Oui-Dev/DISLED/hardware/pcb/connected_status_light.step

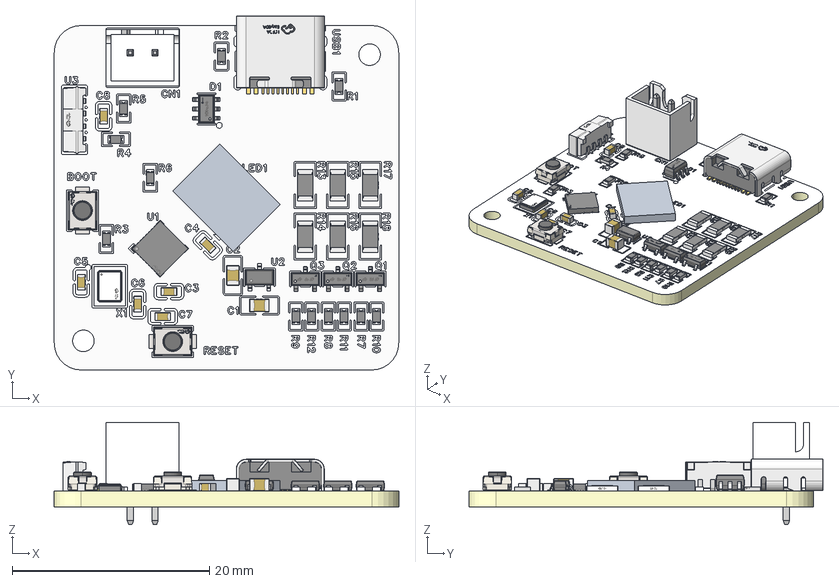
[picture p1: CAD file, 2026-10-25]
hardware/pcb/connected_status_light.step
35.0 x 35.9 x 10.4 mm
Board~z7Zc
TopCopper~z7Zc
BottomCopper~z7Zc
TopSilkscreen~z7Zc x 200
BottomSilkscreen~z7Zc x 48
TopFpcStiffener~z7Zc
BottomFpcStiffener~z7Zc
LED-SMD_6P-L5.0-W5.0-P1.70-LS5.3-TL~default_model~z7Zc
R1206~R1206_L3.2-W1.6-H0.6~z7Zc x 6
R0603~R0603~z7Zc x 12
C0805~C0805_L2.0-W1.3-H1.3~z7Zc x 2
C0603~C0603_L1.6-W0.8-H0.8~z7Zc x 6
SW-SMD_L3.9-W3.0-P4.45~SW-SMD_L3.9-W2.9-H2.0-LS4.8~z7Zc x 2
CRYSTAL-SMD_4P-L3.2-W2.5-BL_SIT8008BI~CRYSTAL-SMD_4P-L3.2-W2.5-BL_ SIT8008BI~z7Zc
LED-SMD_4P-L6.8-W2.4_VEML7700-TR~LED-SMD_4P-L6.8-W2.4_VEML7700-TR~z7Zc
SOT-23-3_L2.9-W1.6-P1.90-LS2.8-BR~SOT-23-3L_ L2.9-W1.6-H1.1-LS2.8-P0.95~z7Zc
QFN-28_L4.0-W4.0-P0.40-BL-EP2.7~QFN-28_L4.0-W4.0-P0.40-BL-EP2.7~z7Zc
USB-C_SMD-TYPE-C-31-M-12_1~USB-C_SMD-TYPE-C-31-M-12_1~z7Zc
CONN-TH_B2B-XH-AM-LF-SN~CONN-TH_B2B-XH-AM-LF-SN~z7Zc
SOT-23-3_L2.9-W1.3-P1.90-LS2.4-BR~SOT-23-3P_ L2.9-W1.3-H1.0-LS2.4-P0.95~z7Zc x 3
SOT-23-6_L2.9-W1.6-P0.95-LS2.8-BL~SOT-23-6_ L2.9-W1.6-H1.5-LS2.8-P0.95~z7Zc
