Oui-Dev/DISLED/hardware/enclosure/top.3mf

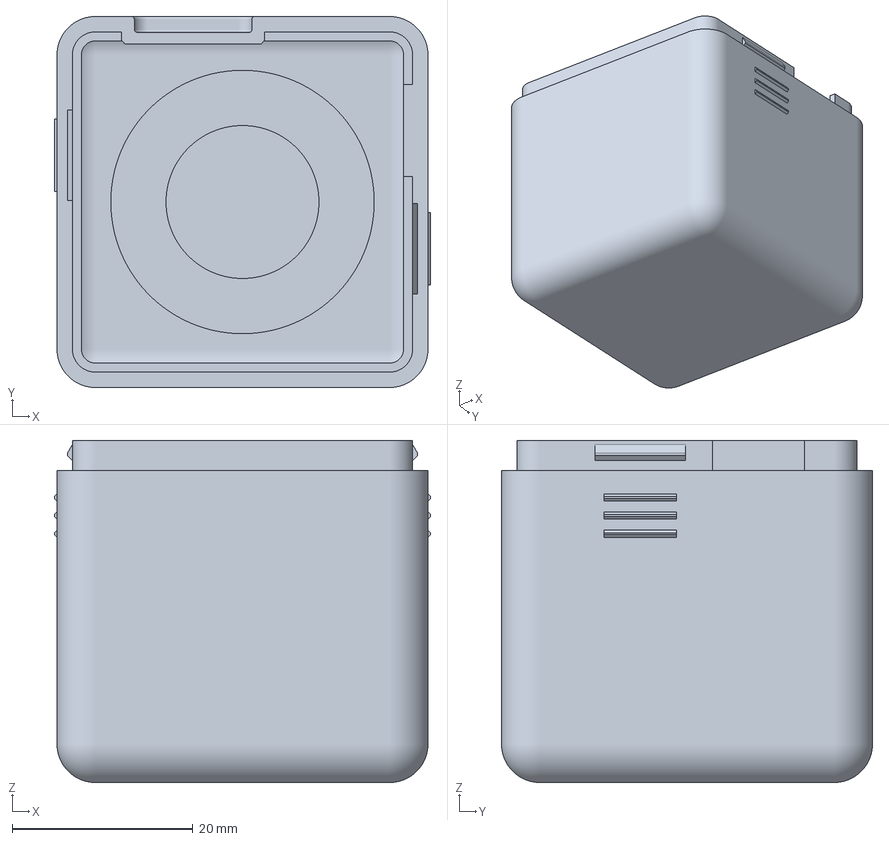
[picture p2: CAD file, 2026-10-31]
hardware/enclosure/top.3mf
41.6 x 41.0 x 37.8 mm
