Oui-Dev/DISLED/hardware/enclosure/copper_ring_cutter.3mf

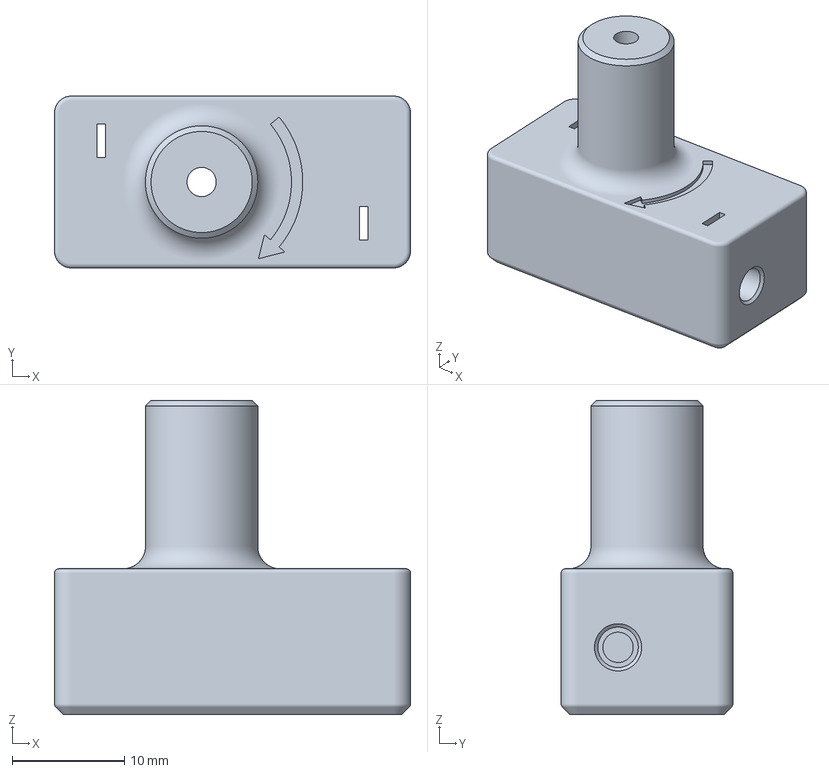
[picture p3: CAD file, 2026-10-24]
hardware/enclosure/copper_ring_cutter.3mf
31.7 x 15.3 x 28.0 mm
