Oui-Dev/DISLED/hardware/enclosure/als_light_cover.3mf

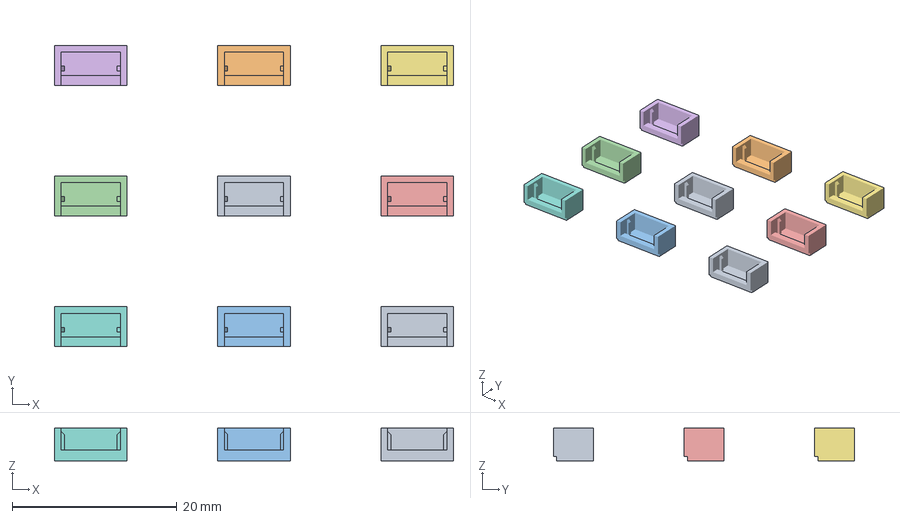
[picture p4: CAD file, 2026-10-24]
hardware/enclosure/als_light_cover.3mf
48.4 x 36.6 x 4.00 mm
als_light_cover x 9
