Oui-Dev/DISLED/hardware/enclosure/anti_slip_foot.3mf

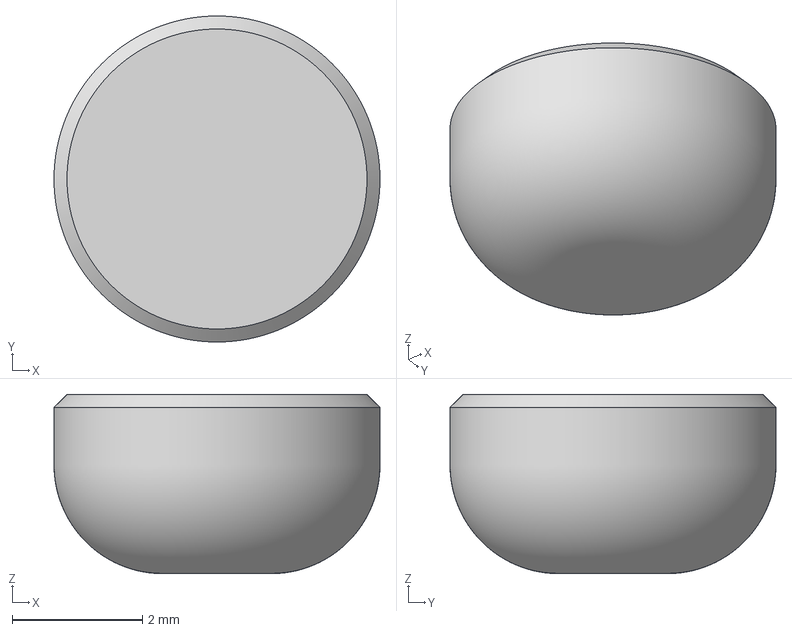
[picture p5: CAD file, 2026-10-19]
hardware/enclosure/anti_slip_foot.3mf
5.00 x 5.00 x 2.75 mm
