Oui-Dev/DISLED/(list of files, cad)

Other CAD files:
hardware/enclosure/bottom.3mf
