Oui-Dev/DISLED/app/src-tauri/installer/dmg-background.png

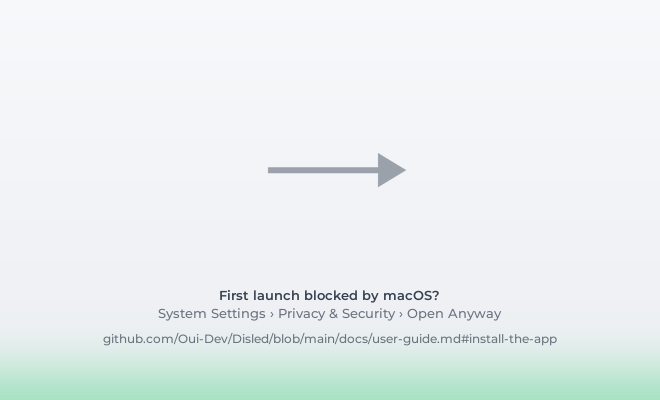
app/src-tauri/installer/dmg-background.png
