Oui-Dev/DISLED/app/src-tauri/installer/nsis-sidebar.bmp

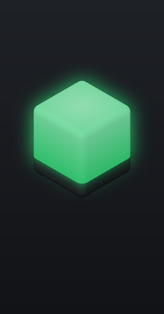
app/src-tauri/installer/nsis-sidebar.bmp
