Oui-Dev/DISLED/docs/images/user-guide/colors-dark.png

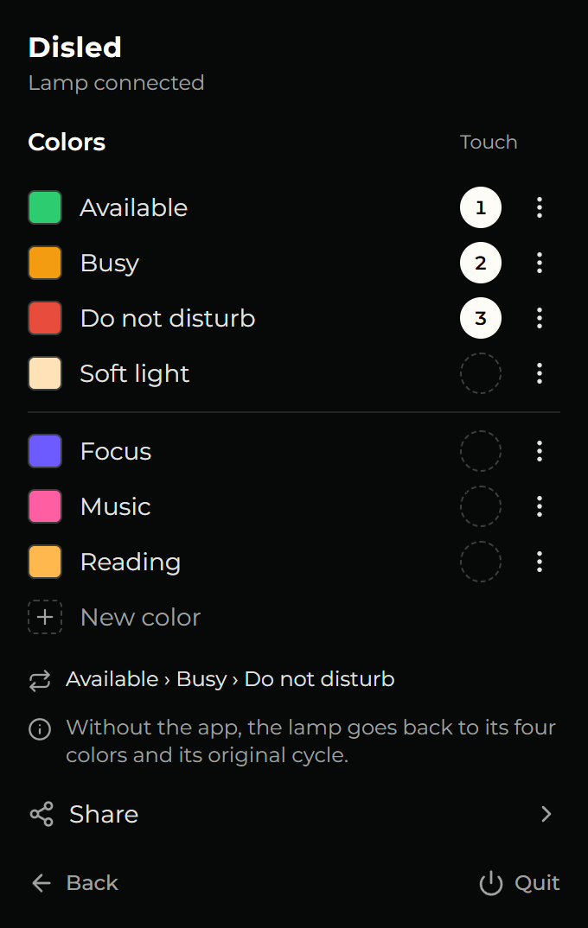
docs/images/user-guide/colors-dark.png
