Oui-Dev/DISLED/docs/images/user-guide/diagnostics-dark.png

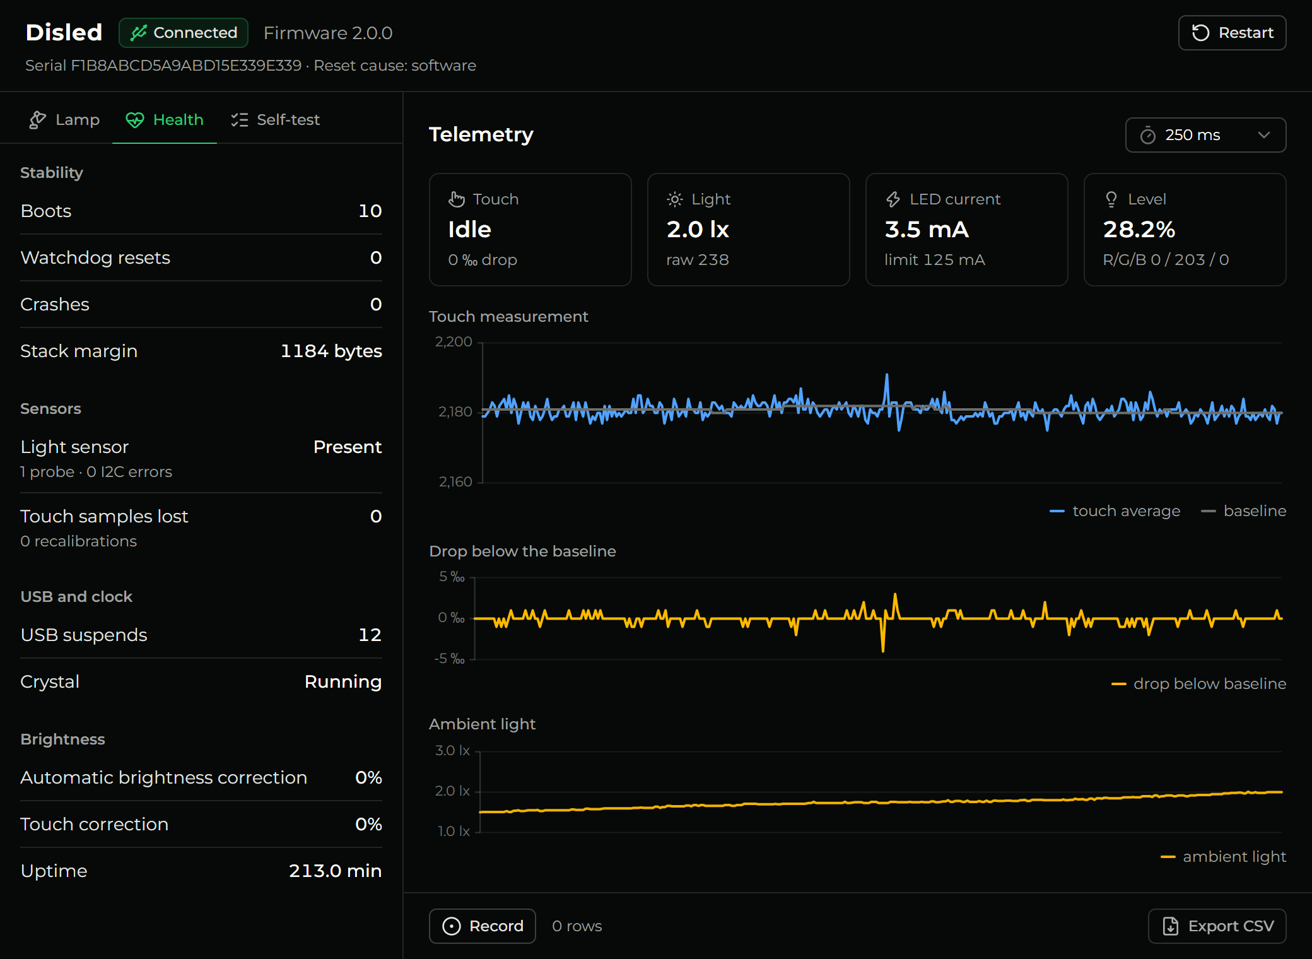
docs/images/user-guide/diagnostics-dark.png
