Oui-Dev/DISLED/docs/images/user-guide/lamp-update-dark.png

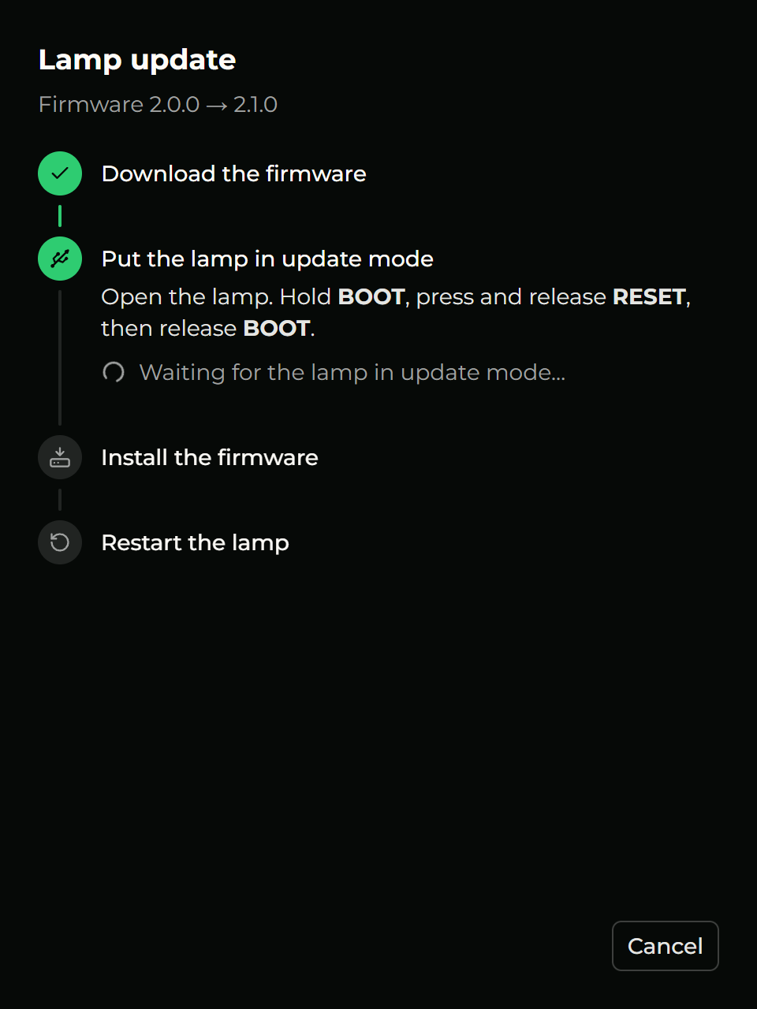
docs/images/user-guide/lamp-update-dark.png
