Oui-Dev/DISLED/docs/images/user-guide/popup-lamp-dark.png

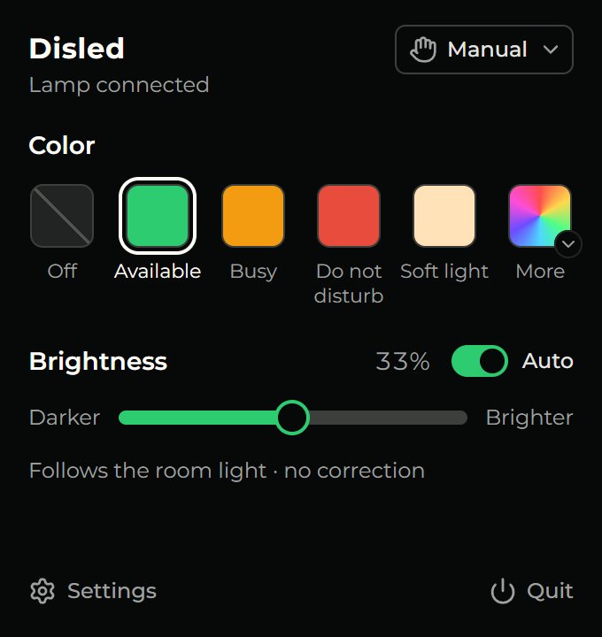
docs/images/user-guide/popup-lamp-dark.png
