Oui-Dev/DISLED/docs/images/user-guide/popup-settings-dark.png

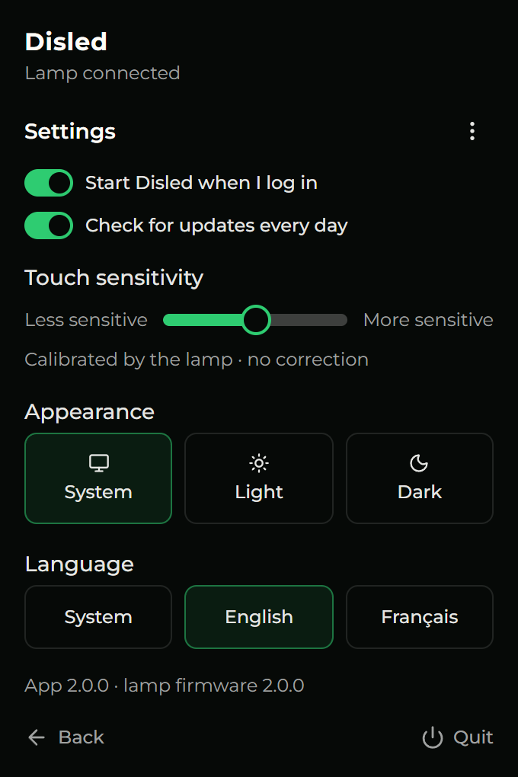
docs/images/user-guide/popup-settings-dark.png
