Oui-Dev/DISLED/firmware/src/drivers/tkey.c

/*
 * SPDX-License-Identifier: GPL-3.0-or-later
 * SPDX-FileCopyrightText: 2026 The Disled contributors
 * Additional permission under GNU GPL version 3 section 7: see LICENSING.md.
 */
#include "tkey.h"

#include <stddef.h>

#include "bsp/board.h"
#include "bsp/bsp_gpio.h"
#include "bsp/bsp_time.h"
#include "bsp/ch32.h"
#include "led_pwm.h"

/* ADC_CTLR1 touch-key bits (WCH TouchKey example, CH32V20x EVT). */
#define ADC_CTLR1_TKENABLE (1u << 24)
#define ADC_CTLR1_BUFEN    (1u << 26)

/* Power of two, so the indices wrap with a mask. */
#define QUEUE_SIZE 32u

/* A measurement takes about 5 us; give up after roughly 100 us. */
#define MEASURE_MAX_POLLS 2000u

typedef struct {
    uint16_t value;
    uint32_t time_ms;
} sample_t;

static uint8_t s_charge_time;
static uint8_t s_discharge_time;
/* Volatile as the indices, so that a slot is read before s_tail frees it
 * to the interrupt. */
static volatile sample_t s_queue[QUEUE_SIZE];
static volatile uint32_t s_head; /* written by the interrupt */
static volatile uint32_t s_tail; /* written by the main loop */
static volatile uint32_t s_lost;

void tkey_init(const tkey_config_t *config)
{
    s_charge_time = config->charge_time;
    s_discharge_time = config->discharge_time;

    RCC_APB2PeriphClockCmd(RCC_APB2Periph_ADC1, ENABLE);
    bsp_gpio_config(BOARD_TOUCH_PORT, BOARD_TOUCH_PIN, GPIO_Mode_AIN, GPIO_Speed_2MHz);

    /* One conversion of the touch channel, started by software: the reset
     * values but for the trigger and the sample time (channel 9: SAMPTR2). */
    ADC1->CTLR2 = ADC_ExternalTrigConv_None;
    ADC1->SAMPTR2 = (uint32_t)config->adc_sample_time << (3u * BOARD_TOUCH_ADC_CHANNEL);
    ADC1->RSQR3 = BOARD_TOUCH_ADC_CHANNEL;
}

/* Runs in the TIM3 interrupt, at the sample point of the PWM period. */
static void measure(void)
{
    /* Writing the charge then the discharge time starts the measurement;
     * it lasts a few microseconds. */
    TKey1->IDATAR1 = s_charge_time;
    TKey1->RDATAR = s_discharge_time;
    uint32_t polls = 0;
    while ((ADC1->STATR & ADC_EOC) == 0u) {
        if (++polls >= MEASURE_MAX_POLLS) {
            s_lost++;
            return;
        }
    }
    const uint16_t value = (uint16_t)TKey1->RDATAR;

    const uint32_t head = s_head;
    if (head - s_tail >= QUEUE_SIZE) {
        s_lost++;
        return;
    }
    s_queue[head & (QUEUE_SIZE - 1u)] = (sample_t){ value, bsp_time_ms() };
    s_head = head + 1u;
}

void tkey_start(void)
{
    ADC1->CTLR2 |= ADC_ADON;
    TKey1->CTLR1 |= ADC_CTLR1_TKENABLE | ADC_CTLR1_BUFEN;
    led_pwm_set_sample_callback(measure);
    /* Every millisecond, from the SysTick interrupt. */
    bsp_time_set_tick_hook(led_pwm_arm_sample);
}

void tkey_stop(void)
{
    bsp_time_set_tick_hook(NULL);
    led_pwm_set_sample_callback(NULL);
    /* Powered down, within the 2.5 mA of a suspended USB device. */
    TKey1->CTLR1 &= ~(ADC_CTLR1_TKENABLE | ADC_CTLR1_BUFEN);
    ADC1->CTLR2 &= ~ADC_ADON;
}

bool tkey_read(uint16_t *sample, uint32_t *time_ms)
{
    const uint32_t tail = s_tail;
    if (tail == s_head) {
        return false;
    }
    const sample_t entry = s_queue[tail & (QUEUE_SIZE - 1u)];
    s_tail = tail + 1u;
    *sample = entry.value;
    *time_ms = entry.time_ms;
    return true;
}

uint32_t tkey_samples_lost(void)
{
    return s_lost;
}
