Oui-Dev/DISLED/firmware/src/bsp/bsp_fault.h

/*
 * SPDX-License-Identifier: GPL-3.0-or-later
 * SPDX-FileCopyrightText: 2026 The Disled contributors
 * Additional permission under GNU GPL version 3 section 7: see LICENSING.md.
 *
 * Fault capture: an exception or a failed assertion saves its cause in the
 * backup registers, which survive a reset but not a power cycle, for the next
 * boot to report. They also count boots, watchdog resets and faults.
 */
#ifndef DISLED_BSP_FAULT_H
#define DISLED_BSP_FAULT_H

#include <stdbool.h>
#include <stdint.h>

/* mcause of a failed DISLED_ASSERT: 0x0A55nnnn, nnnn = source line. */
#define BSP_FAULT_ASSERT_CAUSE 0x0A550000u

typedef struct {
    bool valid;
    uint32_t mcause; /* exception cause (RISC-V mcause) */
    uint32_t mepc;   /* address of the faulting instruction */
    uint32_t mtval;  /* faulting address or instruction */
} fault_record_t;

typedef struct {
    uint16_t boots;          /* since power-up, this one included */
    uint8_t watchdog_resets; /* since power-up, saturates at 255 */
    uint8_t faults;          /* since power-up, saturates at 255 */
    fault_record_t last;     /* last fault since power-up (valid if faults > 0) */
} fault_stats_t;

/* Reads the record left by a fault just before this boot (valid only then)
 * and updates the counters. Call once at boot, after bsp_init(). */
fault_record_t bsp_fault_take(void);

fault_stats_t bsp_fault_stats(void);

#endif /* DISLED_BSP_FAULT_H */
