Oui-Dev/DISLED/(commit log)

2026-10-11 chore: bootstrap monorepo layout, licensing and decision records
    Move the PCB design files into hardware/ (unchanged content), add the
    GPL-3.0-or-later license with a GPLv3 section 7 permission for the WCH
    SDK, the CERN-OHL-S-2.0 hardware license, the lamp behavior
    specification and the architecture decision records for phase 1.
2026-10-11 build(firmware): PlatformIO project with TinyUSB, toolchain spike
    Pin platform-ch32v, the WCH NoneOS SDK and TinyUSB 0.21.0 (submodule),
    add debug/release/native environments, a git-based version script and a
    flash/RAM budget check. The spike builds a vendor HID device with the
    USB descriptors, the 1 ms time base and the USB interrupt glue; ADR 0008
    records the results (interrupt convention, clock tree, memory baseline).
2026-10-11 feat(core): lamp logic, touch detection, light pipeline and protocol codec
    Add the hardware-independent firmware library disled_core:
    - lamp_fsm: power, color cycle and host requests (docs/behavior.md);
    - touch_detector: windowed averaging, drifting baseline, hysteresis,
    debounce, short/long press, object and inverted-touch recalibration;
    - brightness: log-lux curve, slow filter with dead band, manual mode;
    - color, power_limiter, led_output: CIE L* dimming, hue-preserving
    current cap per USB state, fades, single path to the PWM duties;
    - protocol: HID v1 command decoder and message encoders.
    65 Unity tests run natively (pio test -e native); the library also
    builds for the CH32V203 with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
2026-10-11 feat(firmware): board support and peripheral drivers
    - bsp: pin map of board rev 4 (review N3 pins left untouched), clock
    check and ADC clock limit, reset cause, unused pins as analog inputs,
    1 ms tick hook, independent watchdog, fault capture in the backup
    registers;
    - drivers: TIM3 LED PWM with a PWM-synchronous sample point (channel 4,
    output disabled), TouchKey sampling queue with bounded conversion
    wait and phase dithering for the V4 tests, blocking I2C master with
    timeouts and bus recovery, VEML7700 ambient light sensor.
    [board.h, bsp.c, bsp.h, bsp_fault.c, bsp_fault.h, bsp_time.c, bsp_time.h, bsp_watchdog.c]
2026-10-11 feat(firmware): USB transport, debug console and application MVP
    - usb_device: link state (unconfigured/configured/suspended), HID
    command and message queues, CDC console stream in debug builds;
    - diag: timestamped logs and a line console (debug builds only), on top
    of a small heap-free formatter in disled_core;
    - scheduler: table-driven cooperative scheduler in disled_core;
    - app: wiring of touch, light sensor, LED output and host protocol,
    notifications with a state sequence number, rate-limited automatic
    level updates, telemetry stream, delayed RESET, watchdog, WFI idle;
    - app_config: every tunable in one place, first guesses marked "tune";
    - remove 64-bit divisions and enable LTO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
    [app.c, app.h, app_config.c, app_config.h, app_console.c, app_console.h, app_context.h, app_host.c]
2026-10-11 feat(protocol): HID protocol v1 specification and shared test vectors
    protocol/README.md specifies transport, frame, commands and messages.
    protocol/vectors/v1.json holds 16 command and 6 message vectors written
    from the specification by an independent encoder. A PlatformIO script
    turns them into a C header for the native tests, so the firmware codec
    is checked byte for byte; the desktop app will use the same file.
2026-10-11 fix(firmware): one state_seq step per STATE message with new content
    The sequence number grew on every observed change, but notifications
    caused by automatic brightness are throttled and merged, so the host saw
    gaps it could not tell from lost messages. It now grows once per STATE
    message that carries a change; replies without change repeat it, and a
    failed send does not consume a number. Spec updated accordingly.
    [app_host.c]
2026-10-11 feat(app): Tauri 2 test and tuning app
    Rust backend: protocol codec checked against protocol/vectors/v1.json,
    USB worker thread with discovery, reconnection and protocol version
    check, commands to send requests and save CSV recordings. Vue 3 front
    end: connection header, lamp controls that follow the lamp state, live
    telemetry charts and CSV recording. Strict CSP, minimal capabilities.
    Checks: vue-tsc, ESLint, Prettier, rustfmt, clippy -D warnings,
    cargo test (5 tests). Release build compiles (no bundle yet).
2026-10-11 style(firmware): clang-format 23 and cppcheck gate
    Format every firmware source with clang-format 23.1.3 (config in
    firmware/.clang-format; the two tuning tables stay hand-aligned). Run
    cppcheck through pio check on src/ and lib/disled_core at every
    severity; fix its three style findings.
    [app.c, app_config.c, app_console.c, app_host.c, board.h, bsp.c, bsp_time.c, bsp_uid.h]
2026-10-11 fix(firmware): skip light readings until the sensor settles
    Right after power-on or re-initialization the VEML7700 returns 0 until
    its first integration completes. The first reading also seeds the
    brightness filter, so the lamp started at its minimum and crawled up for
    seconds. Readings are now ignored for two integration times, and a
    silent sensor at start-up is probed again after 200 ms instead of 5 s.
    [app.c, app_config.h, app_context.h]
2026-10-19 fix(firmware): bring-up fixes on the first v4 board
    Found on real hardware, all verified on the board:
    - remove the WFI idle: the QingKe core never woke from it, not even on
    the 1 ms tick, so USB never enumerated and the watchdog reset the chip
    every 2 s (low-power idle is phase 2 work);
    - PCLK1 at 36 MHz: the SDK writes PCLK1 in MHz into the 6-bit I2C FREQ
    field before clamping it to 60, so 72 MHz became 8 MHz; APB1 timers now
    run at 72 MHz (PWM 20 kHz with 3600 steps);
    - I2C: WCH-style byte-by-byte reception, bus release and full peripheral
    reset at init and after a failed transfer, clean STOP in the release
    sequence (a START glitch made the next transfer lose arbitration),
    b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
    [app.c, app_console.c, bsp.c, i2c_bus.c, i2c_bus.h]
2026-10-19 feat(firmware): tune warm white and the low brightness end on the board
    - warm white R 63000, G 58000, B 1600 (was 65535/36000/9000, clearly
    pink through the PLA), tuned by eye with the new console command;
    - automatic brightness curve x1.5 below 10 lx (1 lx 3 %, 10 lx 12 %):
    too dim through the PLA in a dark room;
    - console "palette": show or change the colors live (RAM copy), for
    color calibration without reflashing.
2026-10-19 feat(firmware): TouchKey timing measured on the board
    The WCH example timing (charge 16, ADC sample 7.5 cycles) saturates the
    reading at 4093 whatever the electrode does. A live sweep showed that
    the ADC sample time sets the range and the charge time the position in
    it: charge 3 with 1.5 cycles reads about 2600 at rest, with about +-6
    per mille of noise, and a finger on the bare electrode lowers it by
    about 100 per mille. Short and long press, object absorption and
    inverted-touch recalibration worked on the board with these values.
    - tkey_config_t gains the ADC sample time;
    - console "touch charge <c> <d> [s]" tunes the timing live.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
    [app_config.c, app_console.c, tkey.c, tkey.h]
2026-10-19 feat(firmware): tune the orange on the board
    The first orange was hard to tell from the red through the PLA.
2026-10-19 feat(firmware): touch thresholds and orange for the closed enclosure
    Measured through the closed enclosure: a one-hand touch lowers the
    reading by 44-57 per mille, so the 40 per mille threshold left little
    margin. Also keeps the orange the user tuned by hand (green 29000).
2026-10-19 feat(firmware): touch detection with a hand resting near the lid
    Closed-enclosure taps at bring-up showed two faults:
    - a hand near the lid (10-30 per mille) pulled the baseline down by up to
    15 per mille, so later touches needed to land on the electrode ring;
    - with the hand resting near the lid, the signal stayed above the release
    threshold between light taps, which merged into one press (one merge
    lasted 1.7 s, close to a false long press).
    The baseline now freezes in a proximity band (absorbed after the object
    time), press and release are also relative to the floor of the last
    320 ms, and a release re-arms after 100 ms. Replayed on a 33 s recording,
    22 taps are found where the old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
2026-10-19 feat(firmware): shorter touch debounce
    60 ms missed a light tap of about 60 ms through the closed enclosure.
    Replayed on both recordings, 40 ms catches it and adds no false press.
    [app_config.c]
2026-10-19 feat(firmware): compensate the light lost per PWM pulse
    Warm white turned yellow at low levels: at 10 % its blue is a 1-tick
    (14 ns) pulse, too short to light the LED. Each lit channel now gets a
    per-channel pulse loss added to its duty; 5 ticks (70 ns) on blue gave
    back the hue seen at 100 % (tuned by eye). Red and green are not measured
    yet; the console 'pulse' command tunes the losses in RAM.
    Also runs clang-format on the bring-up changes, which repairs the
    DISLED_BOOT_DIAG task macro.
    [app.c, app_config.c, app_config.h, app_console.c]
2026-10-19 feat(firmware): dither the LED PWM to 1/16 of a tick
    At the bottom of the range a channel is only a few 14 ns ticks long:
    whole ticks made the pulse-loss correction too coarse (warm white at
    3 % and 10 % wanted different blue values) and gave visible steps in
    dim fades. The TIM3 update interrupt now dithers each duty over 16
    periods (pattern at 1.25 kHz or faster); led_output works in sub-ticks.
    The telemetry still reports whole ticks.
    Blue pulse loss tuned by eye to 4 3/16 ticks, good at 3 % and 10 %.
    Touch noise unchanged with the interrupt running every period.
    [app.c, app_config.c, app_console.c, app_host.c, led_pwm.c, led_pwm.h, test_pwm_dither.c]
2026-10-19 feat(hardware): add initial 3D models for device housing and mechanical parts
    [als_light_cover.3mf, anti_slip_foot.3mf, bottom_housing.3mf, copper_disk_cutter.3mf, copper_disk_cutter_blade_holder.3mf, top_housing.3mf]
2026-10-19 docs: record the first board bring-up
    - ADR 0009: the design changes the bring-up forced (PCLK1 at 36 MHz and
    a 3600-tick PWM, no WFI, WCH-style I2C reads and bus recovery, LED
    dithering and pulse loss, floor-relative touch detection).
    - Measurements of board F1B9ABCD5A9BBD15E339E339, with the touch
    recordings and what is deferred to the enclosure V2.
    - touch_replay: replays a console recording through touch_detector on
    the build machine, to compare settings before flashing.
    - Architecture, bring-up procedure and protocol notes brought up to date;
    stale 7200-tick references fixed.
    [app_config.h, bsp.c]
2026-10-19 ci: automate releases with release-please
    On every push to main, release-please keeps one release pull request per
    component (firmware fw-vX.Y.Z, app app-vX.Y.Z) with the next version and
    the changelog from the conventional commits. Merging it tags and
    publishes the GitHub release, then the workflow attaches:
    - firmware: release and debug .hex/.bin/.elf with SHA256SUMS;
    - app: Windows .exe (NSIS), macOS .dmg (Apple Silicon), Linux .deb and
    .AppImage, unsigned.
    The app version now lives only in package.json: tauri.conf.json reads it
    and Cargo.toml no longer carries one. The root changelog points to the
    per-component changelogs. docs/releasing.md describes the flow and the
    repository settin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
2026-10-20 fix(app): let the logged-in user reach the lamp on Linux
    Linux lets only root open a USB HID device, so the app could not reach
    the lamp. The .deb now installs a udev rule granting the logged-in user
    access to the lamp (1209:0001, 1209:0002) and to the WCH bootloader for
    wchisp, and reloads udev after install. The README explains how to
    install the rule by hand when running from source.
    The Linux release ships the .deb only; the AppImage is dropped.
2026-10-20 feat(protocol): protocol 1.1 draft and a shared Rust codec
    Protocol 1.1 (draft until the firmware implements it, then frozen):
    - optional commands, each behind a new INFO capability bit:
    SET_AUTO_BIAS (0x06), GET_DIAGNOSTICS (0x07), SELF_TEST (0x08) and
    ENTER_BOOTLOADER (0x09); messages DIAGNOSTICS (0x84) and
    SELF_TEST_RESULT (0x85); error code 4, busy;
    - compatibility rules: minor versions only add commands, messages,
    capability bits, enumeration values or fields at the end of a body;
    decoders accept longer bodies and hosts ignore unknown message types.
    STATE keeps its 9 bytes, so the 1.0 app still decodes it.
    Firmware: the codec decodes and encodes 1.1 (tests and shared vector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
    [app_host.c, device.rs, lib.rs]
2026-10-20 docs: firmware updates from the app, no software bootloader entry
    ADR 0010 supersedes 0004. Tested on the first board: the CH32V203 has no
    boot mode switch (FLASH STATR bit 14 reads back as 0), and a jump into
    the system flash cannot work: the ROM is linked to run at address 0 and
    computes its RAM addresses relative to its own position. The app will
    guide BOOT + RESET and flash with a wchisp sidecar. Also records that
    main() runs in user mode (the startup code sets MPP = 0).
2026-10-20 feat(firmware): self-test, diagnostics, auto brightness bias, low-power idle
    Implements the version 1.1 commands announced in INFO (not
    ENTER_BOOTLOADER, see ADR 0010):
    - SET_AUTO_BIAS: the automatic level is multiplied by (100 + bias)/100
    (brightness core module, the manual level is untouched);
    - GET_DIAGNOSTICS: boots, watchdog resets and faults since power-up and
    the last fault (backup registers, now kept after the report), the
    smallest stack margin (painted stack), I2C errors, light sensor probes,
    lost touch samples, touch re-baselines and USB suspends;
    - SELF_TEST: red, green, blue and white for the operator, light sensor
    and idle touch checks, then a touch within 10 s (pure s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
    [app.c, app_config.c, app_config.h, app_console.c, app_context.h, app_host.c, bsp.c, bsp.h]
2026-10-20 fix(firmware): no WFI in the main loop, wake-up line only in suspend
    With WFI in the main loop the board stopped and the watchdog reset it
    every second, as in phase 1 (89 resets counted by the new diagnostics).
    Four variants hung the same way (SDK __WFI, interrupts masked around
    wfi, __WFE, wfi in machine mode through an ecall), while the same wfi in
    a tight loop inside a task wakes normally. The root cause stays open
    (ADR 0011); the core no longer sleeps.
    USB suspend saves power with the clock instead: internal 8 MHz divided
    by 8 (1 MHz), crystal and PLL off; the loop keeps running and feeding
    the watchdog. EXTI line 18 (USB wake-up) is only enabled during suspend.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
    [app.c, bsp_power.c, bsp_power.h]
2026-10-20 fix(firmware): the self-test touch no longer changes the lamp, warm white step
    The touch that ended the self-test fired a short press at its release
    and stepped the color. The detector can now consume the current touch
    (including one still being debounced): it then fires no short or long
    press. The white step of the self-test is the palette's warm white at
    50 %: equal channels looked pink.
    [app.c, app_config.c]
2026-10-20 docs: phase 2 firmware step, low power ADR, protocol 1.1 frozen
    - ADR 0011: low power without WFI. WFI hangs in the main loop on the
    CH32V203 (four variants tried, root cause open); USB suspend runs the
    core at 1 MHz instead, with the clock restored on the USB wake-up.
    - ADR 0012: protocol version 1 frozen at 1.1, with its compatibility
    rules; the spec now says so.
    - Behavior: brightness bias, diagnostics, self-test, LED off at once on
    suspend.
    - Architecture, bring-up and console docs follow; the board measurements
    gain the phase 2 checks (self-test, suspend, timing, touch noise against
    the PWM phase: no coupling measurable).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
2026-10-20 feat(app): live in the tray with a popup, settings applied at every connection
    - Tray (menu bar) icon showing the lamp: a dot in its color, a ring when
    it is off, a faint ring without a lamp. Left click opens a popup under
    the icon (it hides when it loses the focus); right click: Open,
    Diagnostics, Quit. No Dock icon on macOS.
    - Popup: power, the four colors, automatic brightness with a darker /
    brighter correction (SET_AUTO_BIAS) or a fixed level, and a settings
    page (start at login, diagnostics, versions).
    - Diagnostics window, opened on demand: the phase 1 panels plus the lamp
    diagnostics (refreshed every 2 s) and the self-test.
    - Settings (brightness mode, manual level, corre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
    [device.rs, lib.rs, settings.rs, tray.rs, windows.rs]
2026-10-20 feat(app): updates from GitHub Releases, offered in the popup
    The installed app checks the latest.json of the latest GitHub release 30 s
    after start-up, then once a day (wall clock, so sleep time counts), unless
    the new "Check for updates every day" setting is off. Debug builds never
    check by themselves.
    The popup footer shows "Update to X" when a version is available; the
    settings page installs it ("Install X and restart"), shows the download
    progress and the last error, and can check by hand. Windows uses the NSIS
    installer in passive mode, which restarts the app.
    Signatures must carry the version announced by latest.json
    (requireSignedVersion). The public key is still empty: the release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
    [lib.rs, settings.rs, updates.rs]
2026-10-20 ci: sign the app installers and publish latest.json for the updater
    The app job signs the installers with the update key (two new secrets)
    through tauri.updater.conf.json, so local builds need no key, and
    attaches the signatures; macOS also builds the app bundle, from which the
    updater archive is made. A new updater job writes latest.json once all
    the installers are attached (app/scripts/updater-manifest.mjs), then
    marks the app release as the latest. The firmware job marks the newest
    app release as the latest again after each firmware release.
2026-10-20 ci: draft releases, published once all their binaries are attached
    The repository has immutable releases, so attaching binaries to a
    release that release-please had already published failed (HTTP 422):
    fw 0.2.0 and app 0.2.0 have none. release-please now creates the tag,
    then a draft release (force-tag-creation, draft). The firmware job
    publishes its release after attaching its files, never as the latest
    one; the app-publish job attaches latest.json once the three installers
    are there, then publishes the app release as the latest.
2026-10-20 ci: pin every action to a commit SHA, latest releases
    setup-uv publishes no floating major tag, so `astral-sh/setup-uv@v10`
    could not be resolved. Every action is now pinned to the commit of its
    latest release, with the version in a comment, as Dependabot writes it
    and keeps it up to date: checkout v7.0.1, cache v6.1.0, setup-node
    v7.1.0, upload-artifact v7.0.2, setup-uv v10.3.0, rust-cache v2.9.3,
    release-please-action v5.0.0, rust-toolchain v1 (now with an explicit
    `toolchain: stable`, which the stable branch used to imply).
2026-10-21 feat(app): update the lamp firmware from the app
    With the app updates, the app looks for the newest signed firmware
    release on GitHub and the popup offers it when the lamp runs an older
    one. A window guides the update: BOOT and RESET on the board, the
    WinUSB driver once on Windows. The backend downloads the release
    build, checks its signature with the update key (file name and
    version included), waits for the ROM bootloader, flashes it with the
    wchisp program next to the app and checks the version the lamp then
    reports. A lamp that does not start gets its firmware the same way.
    [device.rs, firmware.rs, lib.rs, settings.rs, updates.rs, wchisp.rs, windows.rs]
2026-10-21 ci: sign the firmware, ship wchisp with the app and attach its source
    The firmware job signs the release build with the update key, the
    version bound to the signature. Each app job builds wchisp 0.3.0
    (static C runtime on Windows) and bundles it, with its license and
    notice, through tauri.wchisp.conf.json. app-publish attaches the
    crates.io package of wchisp, checked against the index, and the
    notice: wchisp is GPL-2.0.
2026-10-21 feat(factory): production tool that flashes, checks and self-tests each board
    tools/disled-factory, a command-line program. Board after board, it
    waits for the ROM bootloader, flashes the release build with wchisp,
    checks the INFO of the restarted lamp, runs SELF_TEST while the
    operator watches the colors and touches the lid, and appends a row to
    a CSV log. It flashes only release builds signed with the update key;
    --unsigned accepts a local or custom firmware, at the user's risk.
    --no-flash tests lamps that already run their firmware. The app
    workflow checks it with the rest of the workspace.
2026-10-21 docs: production tool tried on the first board
2026-10-21 feat(firmware): read the light sensor over its whole range
    The VEML7700 now picks its gain and integration time from each reading,
    as the Vishay application note 84323 describes: from gain 1/8 at 100 ms
    to gain 2 at 400 ms. That is 0.0084 lx per count in the dark instead of
    0.54, and still up to 35 klx in bright light. Gains 1 and 2 stay below
    100 lx, where they are linear; integrations longer than 100 ms serve
    only below about 3 lx, so a lit room still gets ten readings a second.
    The 800 ms integration is left out: its finer counts lie far below
    anything the lamp uses, and it made the lamp see a light switched on in
    the dark up to 0.4 s later.
    TELEMETRY keeps its units; als_raw is now the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
2026-10-21 feat(firmware): automatic brightness that follows the room in about 1.5 s
    The filter now works on a logarithmic scale, in log2 of the lux. A
    change larger than a factor of 2 that lasts 0.4 s is followed with a
    time constant of 0.25 s, so a light switched on or off is followed in
    about 1.5 s; a hand or a shadow passing in front of the sensor moves
    nothing; smaller changes follow with 0.75 s, and differences under about
    2 % never move the lamp. The filter counts the time between readings,
    which come slower in the dark. The old dead band of 10 per mille, which
    froze the low levels, is gone. Back in automatic mode, the level is the
    automatic one at once and the LED output fades to it.
    The curve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
2026-10-21 docs: automatic brightness with sensor ranging (ADR 0017)
2026-10-21 docs: automatic brightness tried on the first board
2026-10-24 feat(app): rounded squares for the tray icon and swatches, and an off swatch
    The tray icon and the color swatches are now rounded squares; the icon's
    corners are rounder so that they still show at 16 px. The On/Off button
    is gone: a first swatch, black and struck through in the grey of its
    outline, turns the lamp off, in the popup and in the Diagnostics window.
    In the popup the swatches share the width in equal columns, so the gaps
    between them stay even. Under the title, the popup says "Lamp connected"
    instead of On or Off.
2026-10-24 feat(app): logo of the lamp on the app and its installers
    The logo is the lamp in isometric view at the enclosure's dimensions:
    the black base, the white cube lit green from inside, every edge rounded
    to 4.25 mm. It replaces the Tauri default icons (desktop shortcut, Start
    menu, Dock, installer files). The Windows installer shows it on its
    welcome and finish pages and in the header of the other pages; the macOS
    disk image gets a background with an arrow toward Applications.
    app/branding/render.py draws the logo and these images; the app icons
    come from the logo with `tauri icon`.
2026-10-24 fix(hid): Limit device scan to lamp vendor to prevent stalls
    [device.rs, lamp.rs]
2026-10-24 refactor(hardware): improve housing design
    Exports of the housing after the first prototype with the PCB:
    - bottom: ALS window 3 x 1.6 mm with its flare matched to the light
    rays, ribs closing the PCB-edge slot under the ALS cover, USB-C recess
    0.3 mm shallower, clip pockets with an 8 deg face and a 0.05 mm preload,
    feet recesses 1 mm deep
    - top: recess for the 28.5/17.5 mm copper ring, hooks with an 8 deg face,
    grip stripes over the clips
    - ALS cover: no more pins (they broke at the root); crush ribs hold it on
    the sensor
    - copper ring cutter: 28.5/17.5 mm ring, blades clamped by M2.5 screws in
    heat-set inserts; the press-fit plug is gone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
    [als_light_cover.3mf, bottom_housing.3mf, copper_disk_cutter.3mf, copper_disk_cutter_blade_holder.3mf, top_housing.3mf]
2026-10-24 fix(firmware): recalibrate touch so a hovering hand is ignored
    On the final board (second board, ring 28.5/17.5 mm), a hand held 1-2 cm
    above the lid or passing over it read as a touch, and a hand held there
    for 2 s as a long press that turned the lamp off.
    Press threshold 28 -> 60 per mille (also used by the self-test), rise
    above the floor 18 -> 50, release 16 -> 34; the debounce stays at 40 ms.
    A finger lands faster than a hand nears the lid, so the rise sorts them.
    Replayed on the labelled recordings added in
    docs/measurements/F1B5ABCD5A97BD15E339E339: every tap and long press is
    found, no hand held or passing, nothing at rest or on the LED steps.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
    [app_config.c, app_config.h]
2026-10-24 refactor(app): TypeScript types generated from the Rust types
    ts-rs writes the types the front end exchanges with the backend to
    app/src/bindings when the tests run (`npm run bindings` in app/): the
    protocol messages and commands, the connection, the settings, the
    update and lamp update statuses. They replace the hand-written mirror of
    lib/protocol.ts and the interfaces copied from the Rust structs.
    The shared crates derive the types behind an optional `ts` feature; the
    app derives them in its tests only, so the release builds and the
    production tool never compile ts-rs. CI fails when the committed types
    differ from what the tests write.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
    [device.rs, firmware.rs, lib.rs, settings.rs, updates.rs, wchisp.rs]
2026-10-24 refactor(app): Pinia stores over a typed IPC layer
    The single reactive store of lib/device.ts becomes Pinia setup stores,
    one per domain: lamp (connection, INFO, STATE), settings, telemetry
    (history and CSV recordings), diagnostics (and the self-test), app
    updates, lamp firmware updates, and the last error. Each window starts
    only the stores it shows: the popup no longer follows telemetry.
    src/ipc holds the backend contract in one place: typed wrappers of the
    Tauri commands and a typed map of the events. The logic that sat in the
    components moves to src/utils, unchanged: version comparison, update
    steps, CSV rows, fault decoding. Errors are typed (backend, rejected by
    the lamp, unreadable)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
2026-10-24 feat(app): color mode and language settings, translated tray and window titles
    Two new settings, saved with the others: the color mode (system, light,
    dark) and the language (system, English, French). The backend applies
    them where the system draws: the theme of the window frames, the tray
    menu and tooltip, the window titles. "System" takes the first language
    of the system the app speaks (sys-locale), English otherwise; the
    windows get it from `locale_get` and `locale-changed`.
    The messages live in src/locales/{en,fr}.json, read by vue-i18n in the
    windows (compiled at build time, so nothing for the CSP to block) and by
    the backend (include_str!). English is the reference: a message French
    l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
2026-10-24 feat(app): popup rebuilt with Nuxt UI and sized to its content
    The popup now draws with Nuxt UI, in both languages and color modes:
    - the colors are a radio group (arrow keys move the choice, the lamp
    colors stay the colors of the LEDs, off is the brand black);
    - automatic brightness is a switch, the correction and the fixed level
    are sliders that speak their value ("+10 %"), throttled while dragged;
    - the settings page gains the color mode and the language selects;
    - errors are alerts, worded in the user's language around the backend's
    own message.
    The window takes the height of its content (popup_resize, within the
    screen and against the tray icon) instead of cutting what does not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
    [lib.rs, tray.rs, windows.rs]
2026-10-24 refactor(app): diagnostics window and charts with Nuxt UI
    The Diagnostics window now draws with Nuxt UI cards, badges, alerts and
    selects, in both languages and color modes. The three telemetry charts
    are Nuxt UI charts (TanStack Charts) instead of the hand-made canvas: a
    legend, axis values with their unit in the user's language, a tooltip
    with the lamp's uptime, keyboard navigation between points. They redraw
    at most ten times per second; with 600 samples streamed every 50 ms the
    window stays at 60 frames per second.
    Restarting the lamp asks in a modal instead of window.confirm, so the
    question is translated and the focus stays in the window. The protocol
    enums (reset cause, change source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
2026-10-24 refactor(app): lamp update window with Nuxt UI
    The lamp update window now draws with Nuxt UI, in both languages and
    color modes: the four steps are a timeline (done, active, stopped in the
    error color), the instructions of the active step come with the BOOT and
    RESET buttons and the Zadig steps in bold or code through vue-i18n's
    translation component (no v-html), and the result is an alert with the
    link to the flashing guide. The steps the update waits for carry a
    spinner that respects reduced motion and is announced to screen readers.
    The window grows to 480 x 640 so that its longest step, the Windows
    driver in French, fits without scrolling. The last window rebuilt, the
    hand-written style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
    [windows.rs]
2026-10-24 refactor(app): fainter tint for the neutral palette, grey off swatch
    The greys and the brand black kept too much of the logo green: green
    weighs more in the eye than the violet of the first brand black. The
    black becomes #050a06 and the greys keep a trace of the tint only
    (chroma 0.005 to 0.007 instead of up to 0.021); every contrast pair still
    passes.
    The off swatch is an unlit grey square, struck through: light grey in
    light mode, where the black was too stark, dark grey in dark mode.
2026-10-24 feat(app): brightness on one slider, as on a phone
    One slider shows the level of the lamp, next to an Auto switch. In
    automatic mode the level follows the room light, and moving the slider
    corrects the curve: the app derives the correction from the level in use
    and the current correction (the lamp shows its curve times
    (100 + bias) / 100), within its limits. Otherwise the slider sets the
    fixed level, as before. After a move the slider keeps the chosen level
    while the lamp follows, then shows the level the lamp reached, so a
    correction at its limit is visible; the hint says so.
    The README describes the slider and the new brand black.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
2026-10-24 refactor(app): popup footer at the bottom and smaller, compact alert, cards for the settings
    The window fits the page and the footer, measured apart, so that the
    footer stays at the bottom even while the window catches up with the
    content. Its buttons and the error alert get smaller, the color mode and
    the language become radio cards side by side, and Escape simply hides the
    popup now that it holds no list. The popup starts at 300 px, the height
    of its lamp page.
2026-10-24 refactor(app): smaller popup controls, a 360 px popup, tidier diagnostics header
    - The brightness level is not shown while unknown, instead of a dash.
    - The settings switches and the update and diagnostics buttons are small.
    - The popup is at least 360 px tall: tauri.conf.json, and a floor in
    resize_popup since the height follows the content.
    - Diagnostics: Restart is small and on the right; the self-test button is
    neutral, as the telemetry ones.
2026-10-24 fix(app): stop the lamp telemetry when the Diagnostics window closes
    A lamp streams until told to stop: closing the window left it sending
    samples that nobody read. The backend now sends SET_TELEMETRY 0 when the
    window is destroyed.
    [windows.rs]
2026-10-24 fix(app): keep the last error on show while the app polls the lamp
    Every command that went through cleared the last error, and the
    Diagnostics window asks for the diagnostics every 2 s: an error lasted
    2 s at most. The commands the app sends on its own (polling, the
    telemetry started again, INFO and STATE on start) now leave it on show;
    it goes when something the user asked for succeeds, when the lamp comes
    back, or when the user closes it (new close button on the alerts).
2026-10-24 refactor(app): telemetry at 250 ms, recording at the bottom, a legend per chart
    - The stream starts at 250 ms: the charts hold the last 2.5 min.
    - Record and export move to a footer under the charts, at hand
    whatever the scroll; the period stays above them.
    - Each chart has its legend, under it on the right (UChart's own sits
    on top, centered, and only with two series).
    - The charts share the height the panel has left: no scroll at the
    default size, taller charts in a larger window.
    - The self-test button is as small as the telemetry ones.
2026-10-24 feat(app): popup settings with the rare actions in a "more" menu
    - The settings page keeps the settings (start at login, daily update
    checks, color mode, language) and the versions, on one line.
    - Check for updates, Diagnostics and reinstall the lamp firmware move to
    a "⋯" menu next to the title; its last lines say where the updates
    stand. The menu is not modal, and Escape closes it before it hides
    the popup.
    - An update on offer (the app first, then the lamp) shows as an alert on
    top of the settings, with its button.
    - Shorter update button labels; wrap-break-word, Tailwind's canonical
    name for break-words.
2026-10-24 fix(app): reinstall the lamp firmware from the settings menu at any time
    The menu offered it only without a lamp, as the old link did. The lamp
    update window takes every case: a lamp up to date (reinstall), one that
    no longer starts (its update mode), no firmware known yet (check).
2026-10-24 fix(app): no scrollbar flash while the popup grows
    Going to the settings, the page grows before the window does: for a
    frame it overflowed, and Windows drew a scrollbar. The popup page now
    scrolls only when the screen is too short for it: popup_resize returns
    the height the window took, and the page scrolls when that is less than
    its own.
    [lib.rs, windows.rs]
2026-10-25 feat(app): the brightness slider sets the correction in automatic mode
    In automatic mode the slider showed the level in use, so it moved by
    itself whenever the room light changed. It sets the "darker / brighter"
    correction again, -50 to +50 % by 5 %, and only moves under the user's
    hand; the level in use stays next to the Auto switch. The fixed level
    keeps its slider.
2026-10-25 fix(app): the brightness slider stays put when the mode changes
    The fixed level row was 20 px tall (its larger sun), the automatic one
    16 px (its labels): switching modes moved the slider by 2 px and the
    hint by 4 px. Both modes now share one row, as tall as the larger sun.
2026-10-25 refactor: global cleanup & some fix
    [windows.rs]
2026-10-25 refactor(hardware): one folder per design, without versions in the names
    hardware/pcb holds the board in production (v4, silkscreen "Rev 1.0")
    and now its STEP model; hardware/enclosure, the printed parts and the
    ring cutter (the docs call it the enclosure). The earlier boards, the
    renders and the review stay in the history: each version goes out as a
    release with its files.
    [als_light_cover.3mf, anti_slip_foot.3mf, bottom.3mf, connected_status_light.step, copper_ring_cutter.3mf, top.3mf]
2026-10-25 docs(hardware): changelogs of the PCB and the enclosure
    Written by hand, in the sections of the software changelogs. The board
    versions come from the evolution chapter of the v4 review and the parts
    lists of the four projects; the enclosure ones from the commits of its
    exports.
2026-10-25 ci: hardware releases from a workflow run by hand
    hardware-release.yml releases the PCB or the enclosure from main: the
    tag, the files of its folder and the notes from its changelog, published
    complete and never as the latest release, which the app updater reads.
    hardware-backfill.yml releases the earlier designs once, from the
    commits that brought them, oldest first; delete it after its run.
2026-10-25 docs: hardware releases, never the latest (ADR 0019)
    How to release the PCB and the enclosure, the decision behind it, and
    the new layout in the READMEs. The app installers point at the latest
    release, which stays the app's while hardware releases join the list.
2026-10-25 ci: release enclosure 0.1.0 from a tag pushed by hand
    The workflow token may not create a tag on a commit whose workflow files
    differ from main's: the enclosure 0.1.0 release, on d8a4430, failed with
    HTTP 403, while the PCB 0.x tags went through (their commit has no
    workflows). hardware-release now accepts a tag that already points at
    the commit, and the backfill keeps the two enclosure releases.
2026-10-25 ci: hardware releases of the commit that runs, without the backfill
    The backfill is done: PCB 0.1.0 to 1.0.0 and enclosure 1.0.0 went out
    through the workflow, enclosure 0.1.0 by hand. GitHub refuses the
    workflow token the release of a commit whose workflow files differ from
    main's (HTTP 403), even with its tag pushed by hand, so the workflow
    keeps to the commit that runs; docs/releasing.md tells how to release an
    older one.
2026-10-25 docs: status, links and USB IDs request in the README and licensing
    [telemetry-idle-3h42.csv]
2026-10-25 docs: remove the decision records and the measurements
    [telemetry-idle-3h42.csv]
2026-10-25 docs: describe the current state, each fact in one place
2026-10-25 refactor(firmware): remove the tuning commands and the bring-up switches
2026-10-26 build: pin the Node.js and Rust versions
2026-10-26 docs(firmware): comments cut down to the contract and the reasons
2026-10-26 docs(app): comments cut down to the contract and the reasons
2026-10-26 docs(factory): module comment cut down to three lines
2026-10-26 docs: comments of the shared crates cut down
2026-10-26 feat(app): mark the settings button when an update is on offer
2026-10-26 fix(app): hide the popup instead of closing it on Alt+F4
    [main.rs, windows.rs]
2026-10-26 fix(app): open Diagnostics from the tray menu off the event loop
    [tray.rs]
2026-10-26 fix(app): cancel the lamp update when its window closes
    [firmware.rs, windows.rs]
2026-10-26 fix(app): time out stalled update requests
    [updates.rs]
2026-10-26 fix(app): apply the settings at the first INFO of a connection only
    [device.rs]
2026-10-26 fix(app): let a second install click join the running lamp update
    [firmware.rs]
2026-10-26 fix(app): keep a saved setting from failing when the lamp leaves
    [main.rs]
2026-10-26 fix(app): run one update check at a time
    [firmware.rs, updates.rs]
2026-10-26 fix(app): grant the devtools shortcut to debug builds only and tighten the CSP
    [main.rs]
2026-10-26 fix(app): keep backend values from being overwritten by older command answers
    [firmware.rs, main.rs, updates.rs]
2026-10-26 perf(app): format each sample's uptime once and pause hidden charts
2026-10-27 fix(firmware): report a self-test cut short by a USB suspend
    [app.c]
2026-10-27 fix(firmware): pass the self-test touch on a press, not on a hand near the lid
    [app.c, app_config.c, app_config.h]
2026-10-27 fix(firmware): stop the telemetry when the host leaves, whatever else changed
    [app_host.c]
2026-10-27 fix(firmware): keep room for the answers while the host reads nothing
    [app_host.c]
2026-10-27 perf(firmware): power the touch ADC down during USB suspend
2026-10-27 fix(firmware): keep the time from going back when the core clock changes
    [bsp_time.c, bsp_time.h]
2026-10-27 fix(firmware): read a touch sample before freeing its slot to the interrupt
    [tkey.c]
2026-10-27 fix(firmware): end a busy wait of a millisecond or more
    [bsp_time.c, bsp_time.h]
2026-10-27 fix(firmware): suspend at 1 MHz again after the crystal fails on resume
    [app.c, bsp_power.c, bsp_power.h]
2026-10-27 perf(firmware): use known clock values and read the reset cause once
    [bsp.c, bsp_power.c, bsp_power.h]
2026-10-27 fix(firmware): start the crystal at boot with bounded waits
    [bsp.c, bsp_power.c, bsp_power.h, bsp_time.h, main.c]
2026-10-27 perf(firmware): set the pin modes without the SDK's GPIO_Init
2026-10-27 perf(firmware): drive the LED timer through its registers
2026-10-27 perf(firmware): set the touch ADC up through its registers
2026-10-27 refactor(firmware): read the light sensor at a single range
2026-10-27 refactor(firmware): reset the I2C bus after any failed transfer
    [app.c, i2c_bus.c, i2c_bus.h]
2026-10-27 docs: say that the self-test only checks that the light sensor answers
2026-10-27 refactor(firmware): count touch timeouts as lost samples
2026-10-27 refactor(firmware): drop a touch delta clamp that never applies
2026-10-27 refactor(firmware): track the touch baseline zones with one timer
2026-10-27 docs: give the share of power warm white keeps under the cap
2026-10-27 refactor(firmware): remove the unused TinyUSB millisecond hook
2026-10-30 fix(app): make popup a macOS panel to prevent issue on full screen apps
    [main.rs, windows.rs]
2026-10-31 docs: add the assembly guide and rework the bring-up measurements
2026-10-31 fix(hardware): enclosure clips with 45° faces that keep their hold
    [bottom.3mf, top.3mf]
2026-10-31 docs(hardware): enclosure 1.1.0 changelog and clip depth
2026-10-31 feat(hardware): variable layer heights for the enclosure base
    [bottom.3mf]
2026-10-31 docs(hardware): enclosure 1.1.1 changelog
2026-11-09 docs(firmware): update the touch, alert, host silence and PID comments
2026-11-09 feat(app): button and menu labels without an ellipsis, and guards on the texts
2026-11-09 feat(app): the plugin host: manifests, rules and states by key, fingerprints and approvals, the local server and its tokens, the programs
2026-11-11 ci: refuse a macOS bundle that asks for the microphone or the camera
2026-11-11 fix(app): the pointer cursor on the enabled buttons, which Tailwind 4 no longer gives
2026-11-11 refactor(app): no pointer class on the buttons, which get it from the base style
2026-11-11 refactor(app): Nuxt UI buttons instead of native ones
2026-11-11 fix(firmware): keep the red in dim colors
    [app_config.c]
2026-11-11 fix(firmware): a warmer white for the custom colors
    [app_config.c]
2026-11-11 fix(firmware): drive the LED gates with 10 MHz edges
    [led_pwm.c]
2026-11-11 fix(firmware): a pulse loss that follows the length of the pulse
    [app.c, app_config.c, app_config.h]
2026-11-11 docs(hardware): the 100 Ω gate resistors of the LED, for the next board revision
2026-11-11 fix(app): radios named once, in the current language, and arrows that browse the colors of a popover
